Maacciiej/Electronic_Pedometer/Electronic_Pedometer.PNG

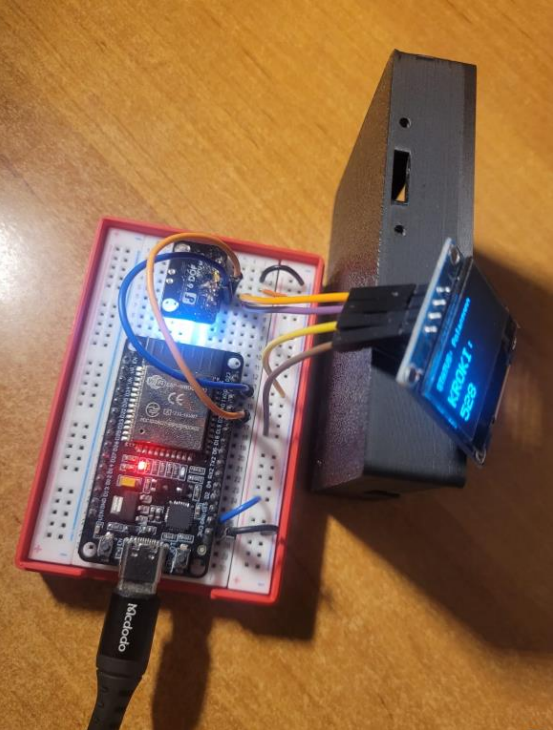
Electronic_Pedometer.PNG
